MBooten/AutomatedBalancingRobot/Picture_Robot&APP.jpg

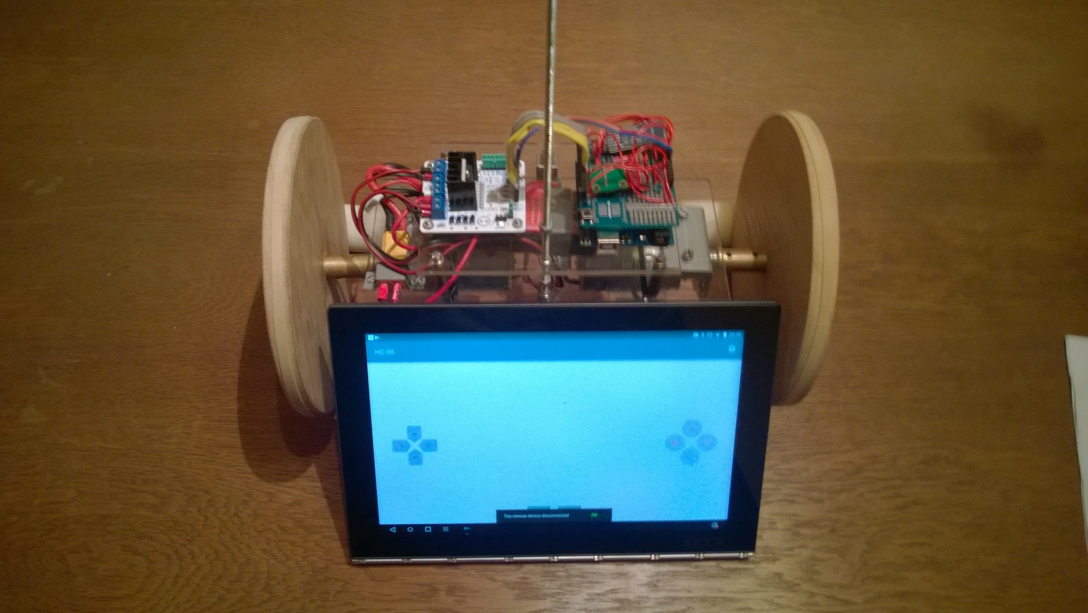
Picture_Robot&APP.jpg
